FabianFriederichs/etching_bath_heater/README.md

# etching_bath_heater
An AVR 8-Bit µC based etching bath controller including PID controlled heater and agitation.
