FabianFriederichs/etching_bath_heater/case/STLs/MainbardAndMosfets.stl

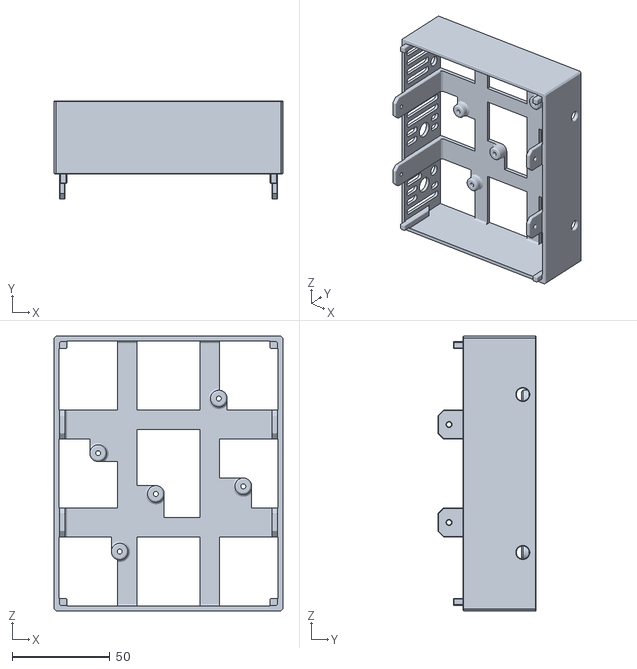
[picture p1: CAD file, 2020-09-18]
case/STLs/MainbardAndMosfets.stl
117.3 x 50.5 x 141.0
