FabianFriederichs/etching_bath_heater/case/MotorHolder.step

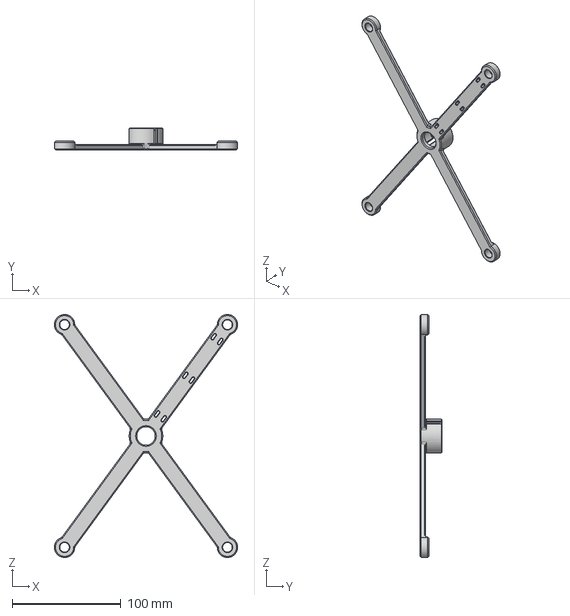
[picture p2: CAD file, 2020-10-12]
case/MotorHolder.step
168.8 x 20.0 x 223.8 mm
