FabianFriederichs/etching_bath_heater/case/STLs/Sensors_5VReg_Fan_Base.stl

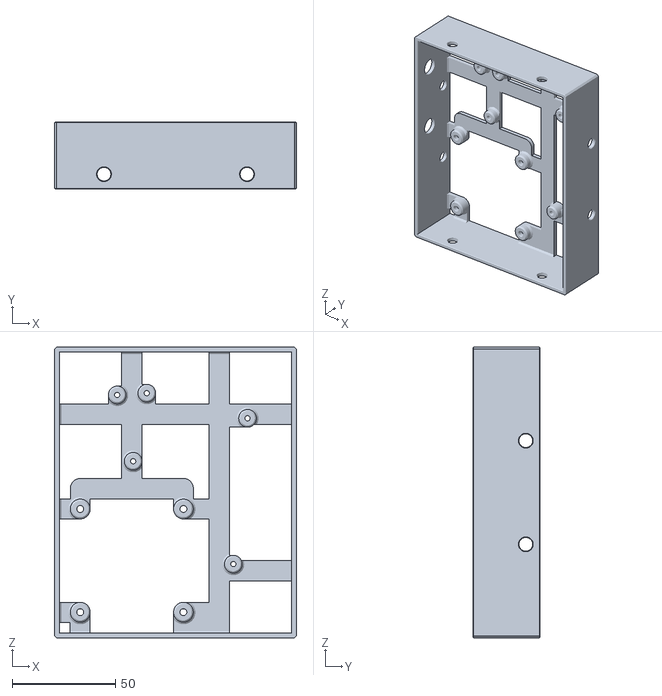
[picture p3: CAD file, 2020-09-18]
case/STLs/Sensors_5VReg_Fan_Base.stl
117.3 x 32.5 x 141.0
