FabianFriederichs/etching_bath_heater/case/MagnetHolder.step

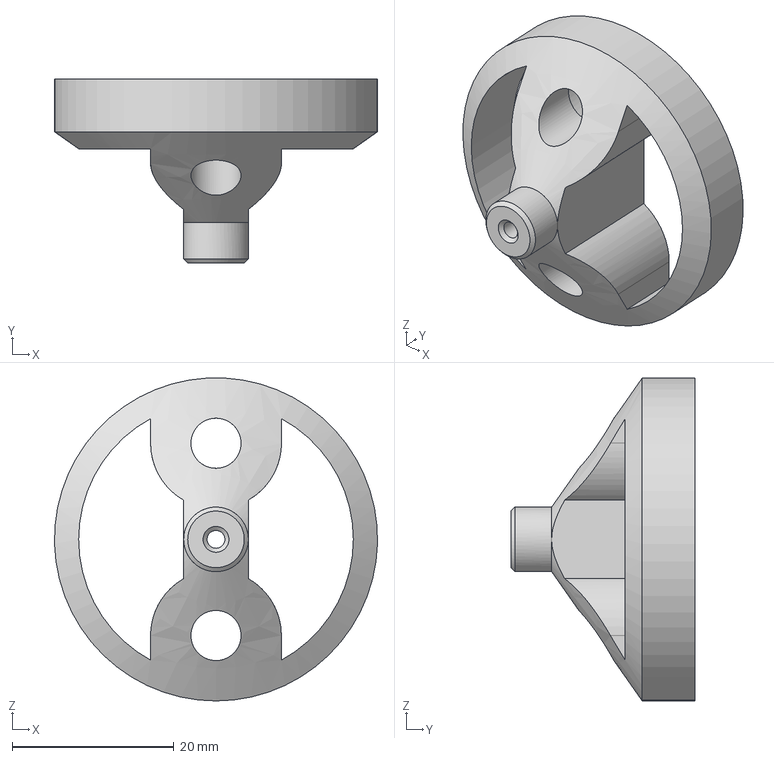
[picture p4: CAD file, 2020-10-12]
case/MagnetHolder.step
40.0 x 22.8 x 40.0 mm
