FabianFriederichs/etching_bath_heater/case/STLs/DisplayPart.stl

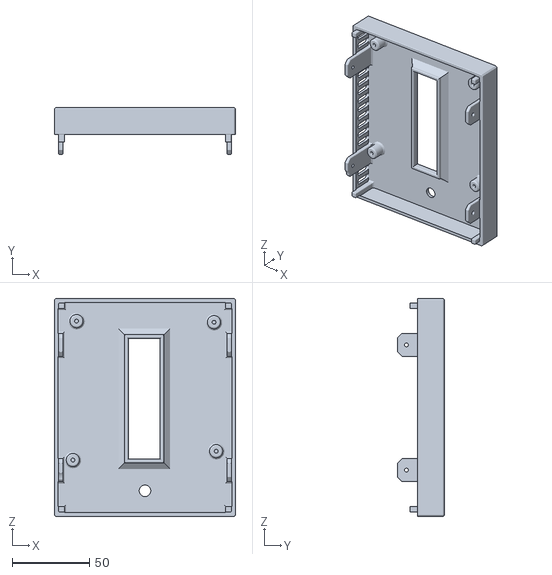
[picture p5: CAD file, 2020-09-18]
case/STLs/DisplayPart.stl
117.3 x 30.5 x 141.0
