FabianFriederichs/etching_bath_heater/case/PSUThing.step

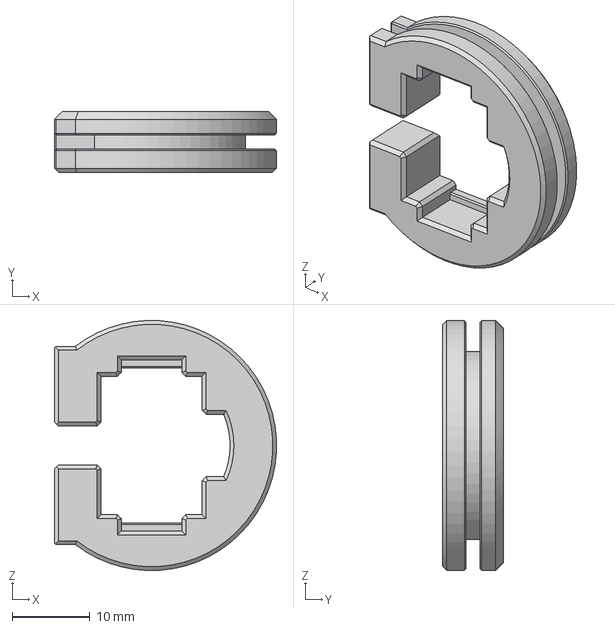
[picture p6: CAD file, 2020-09-29]
case/PSUThing.step
28.6 x 7.80 x 32.2 mm
