FabianFriederichs/etching_bath_heater/case/STLs/Base.stl

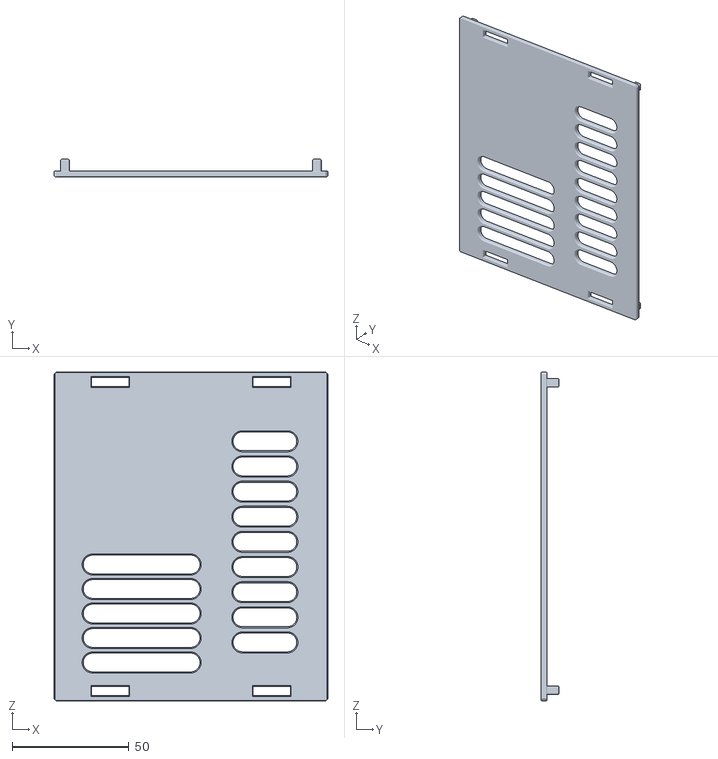
[picture p7: CAD file, 2020-09-18]
case/STLs/Base.stl
117.3 x 7.50 x 141.0
