FabianFriederichs/etching_bath_heater/case/RotEncKnob.step

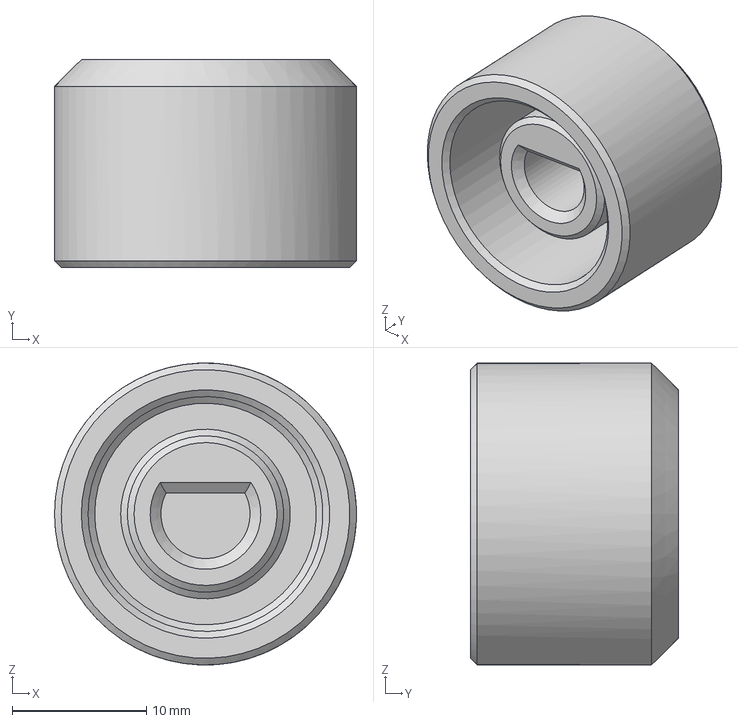
[picture p8: CAD file, 2020-09-28]
case/RotEncKnob.step
22.5 x 15.5 x 22.5 mm
