FabianFriederichs/etching_bath_heater/case/STLs/Stand.stl

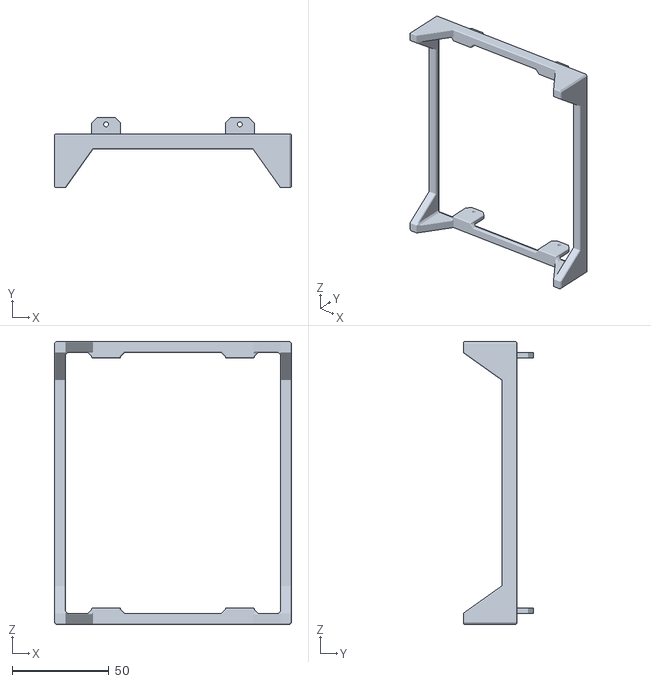
[picture p9: CAD file, 2020-09-18]
case/STLs/Stand.stl
122.9 x 36.5 x 146.6
