FabianFriederichs/etching_bath_heater/case/HeaterCase.step

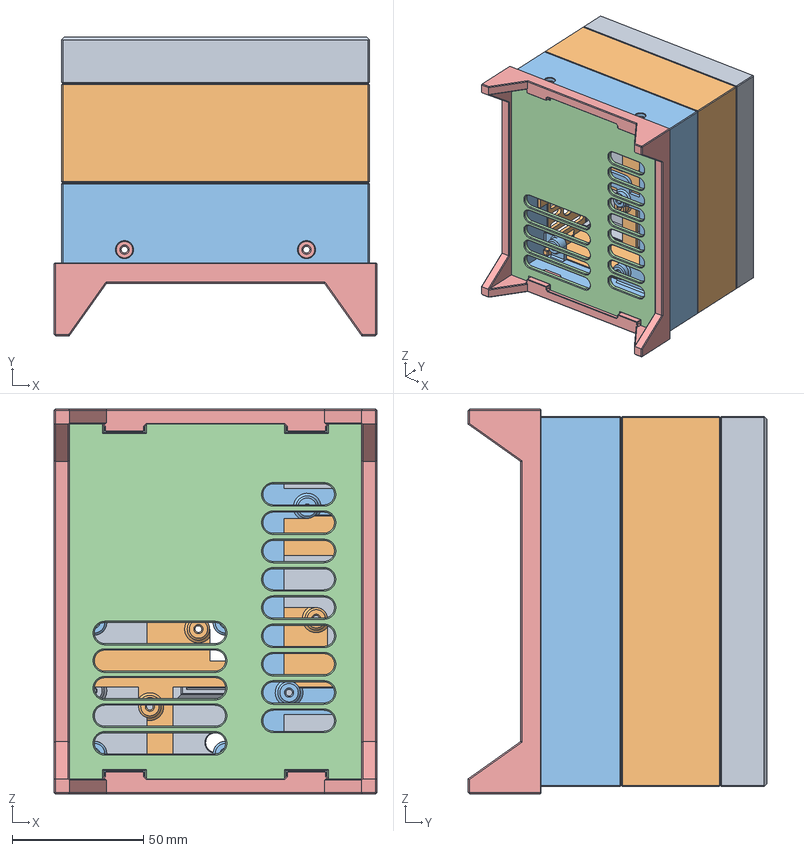
[picture p10: CAD file, 2020-09-15]
case/HeaterCase.step
122.9 x 113.7 x 146.6 mm
DisplayPart
MainbardAndMosfets
Sensors_5VReg_Fan_Base
Base
Stand
