FabianFriederichs/etching_bath_heater/case/STLs/StrainReliefPlugTighter.stl

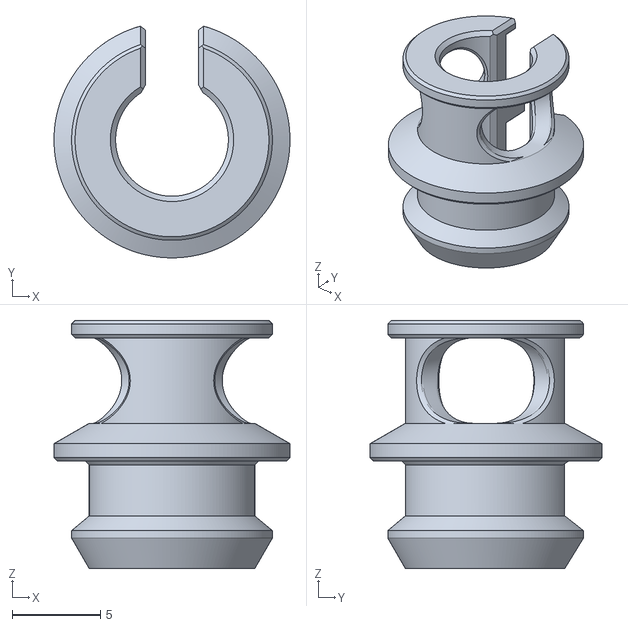
[picture p11: CAD file, 2020-09-18]
case/STLs/StrainReliefPlugTighter.stl
13.4 x 13.2 x 14.1
