FabianFriederichs/etching_bath_heater/(list of files, cad)

Other CAD files:
case/MagnetHolder.f3d
case/MotorHolder.f3d
case/PSUThing.f3d
case/RotEncKnob.f3d
case/STLs/MagnetHolder.stl
case/STLs/MotorHolder.stl
case/STLs/PSUThing.stl
case/STLs/RotEncKnob.stl
case/StrainReliefPlug.f3d
