FabianFriederichs/etching_bath_heater/pcbs_eagle/heater_motor.brd

## EAGLE design pcbs_eagle/heater_motor.brd (2020-02-20)

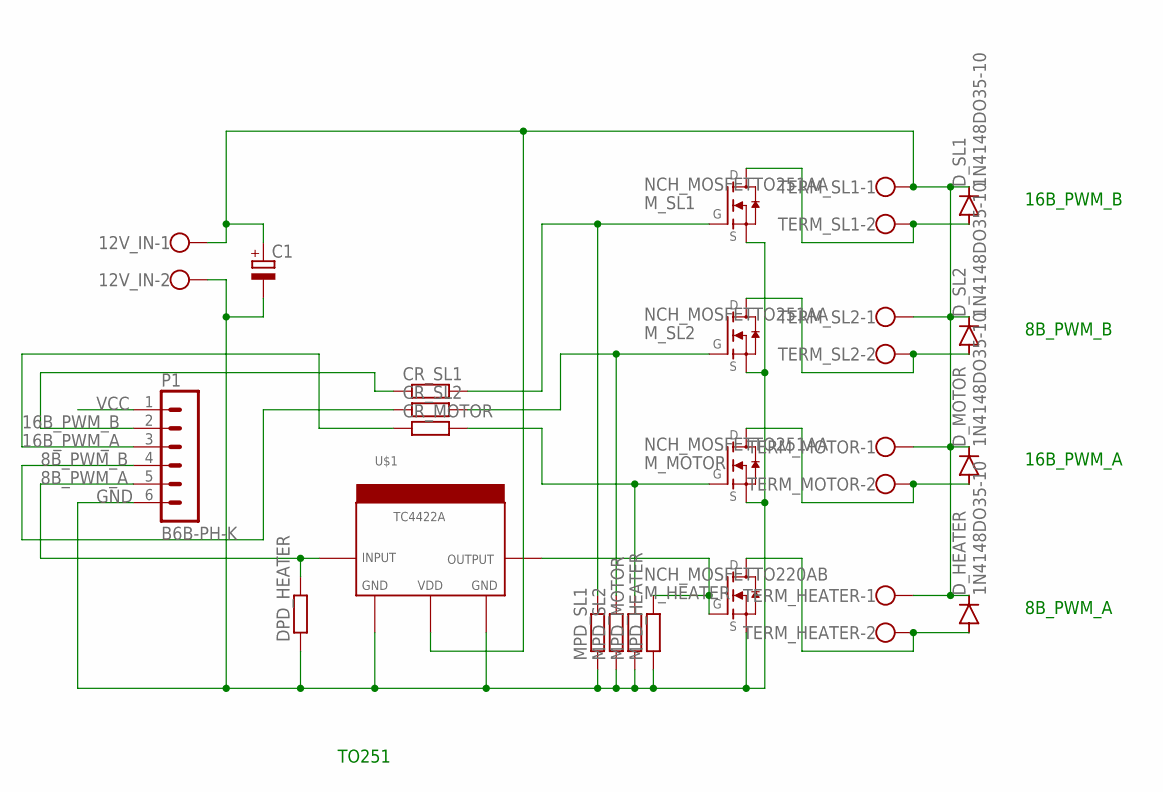
[picture p12: schematic heater_motor.sch]

Parts:
12V_IN: W237-102
C1: CPOL-EUE5-10.5; E5-10,5
CR_MOTOR: R-EU_0207/10; 0207/10
CR_SL1, CR_SL2: R-EU_0207/10; 0207/10
DPD_HEATER: R-EU_0207/10; 0207/10
D_HEATER: 1N4148DO35-10; DO35-10
D_MOTOR: 1N4148DO35-10; DO35-10
D_SL1, D_SL2: 1N4148DO35-10; DO35-10
MPD_HEATER: R-EU_0207/10; 0207/10
MPD_MOTOR: R-EU_0207/10; 0207/10
MPD_SL1, MPD_SL2: R-EU_0207/10; 0207/10
M_HEATER: NCH_MOSFETTO220AB; TO220AB
M_MOTOR: NCH_MOSFETTO251AA; TO251AA
M_SL1, M_SL2: NCH_MOSFETTO251AA; TO251AA
P1: B6B-PH-K
TERM_HEATER: W237-102
TERM_MOTOR: W237-102
TERM_SL1, TERM_SL2: W237-102
U$1: TC4422ASPACE_LEGS; TO220-52

Connections:
8B_PWM_A: DPD_HEATER.2, P1.5, U$1.1 (INPUT)
8B_PWM_B: CR_SL2.1, P1.4
16B_PWM_A: CR_MOTOR.1, P1.3
16B_PWM_B: CR_SL1.1, P1.2
GND: 12V_IN.2, C1.-, DPD_HEATER.1, MPD_HEATER.1, MPD_MOTOR.1, MPD_SL1.1, MPD_SL2.1, M_HEATER.3 (S), M_MOTOR.3 (S), M_SL1.3 (S), M_SL2.3 (S), P1.6, U$1.2 (GND1), U$1.4 (GND2)
unnamed: D_HEATER.A, M_HEATER.2 (D), TERM_HEATER.2
unnamed: MPD_HEATER.2, M_HEATER.1 (G), U$1.5 (OUTPUT)
unnamed: D_SL1.A, M_SL1.2 (D), TERM_SL1.2
unnamed: D_SL2.A, M_SL2.2 (D), TERM_SL2.2
unnamed: D_MOTOR.A, M_MOTOR.2 (D), TERM_MOTOR.2
unnamed: CR_MOTOR.2, MPD_MOTOR.2, M_MOTOR.1 (G)
unnamed: CR_SL2.2, MPD_SL2.2, M_SL2.1 (G)
unnamed: CR_SL1.2, MPD_SL1.2, M_SL1.1 (G)
unnamed: 12V_IN.1, C1.+, D_HEATER.C, D_MOTOR.C, D_SL1.C, D_SL2.C, TERM_HEATER.1, TERM_MOTOR.1, TERM_SL1.1, TERM_SL2.1, U$1.3 (VDD)
VCC: P1.1

Notes on the sheet:
TO251
8B_PWM_A
8B_PWM_B
16B_PWM_A
16B_PWM_B

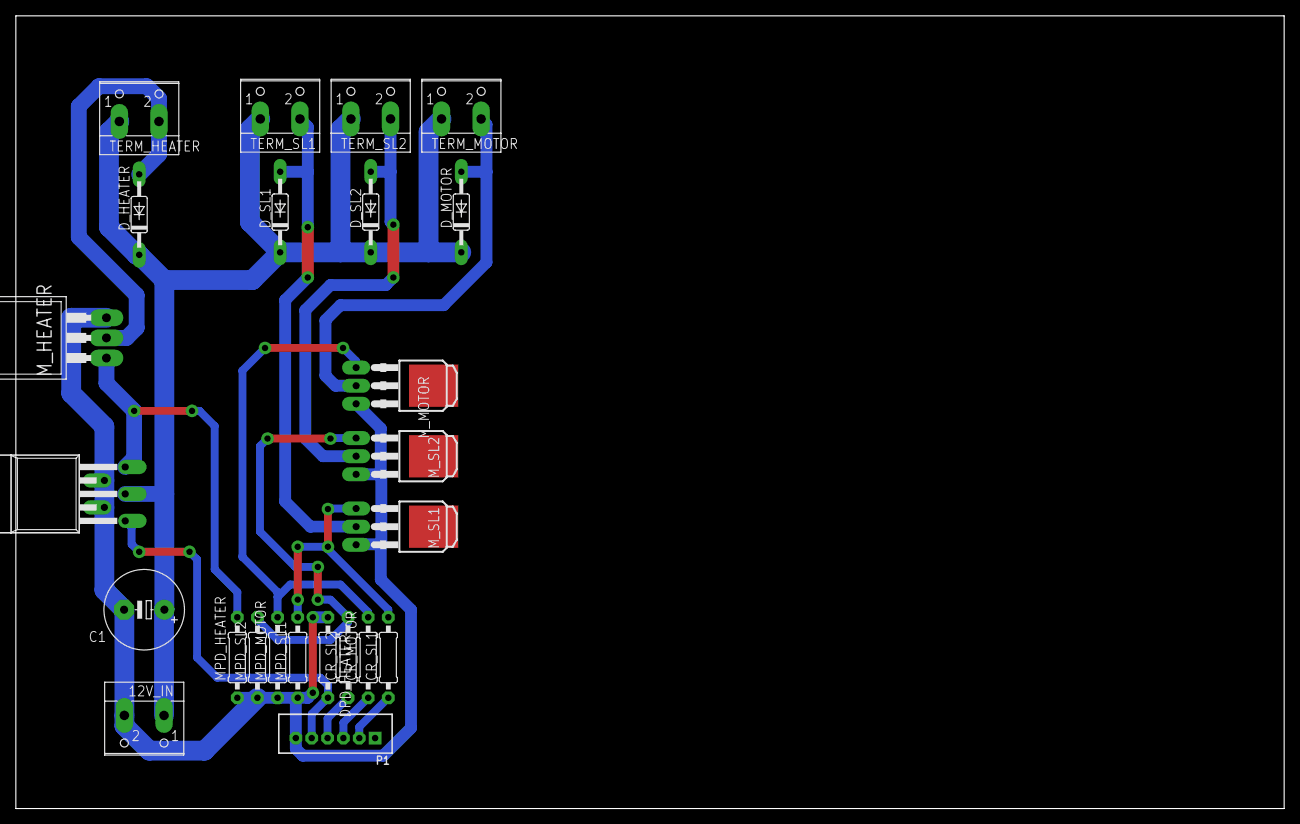
[picture p13: board heater_motor.brd from above]

Board: 2 copper layers, 160.0 x 100.0 mm, 24 parts (0 on the bottom side), 14 nets.
