FabianFriederichs/etching_bath_heater/pcbs_eagle/display.brd

## EAGLE design pcbs_eagle/display.brd (2020-02-20)

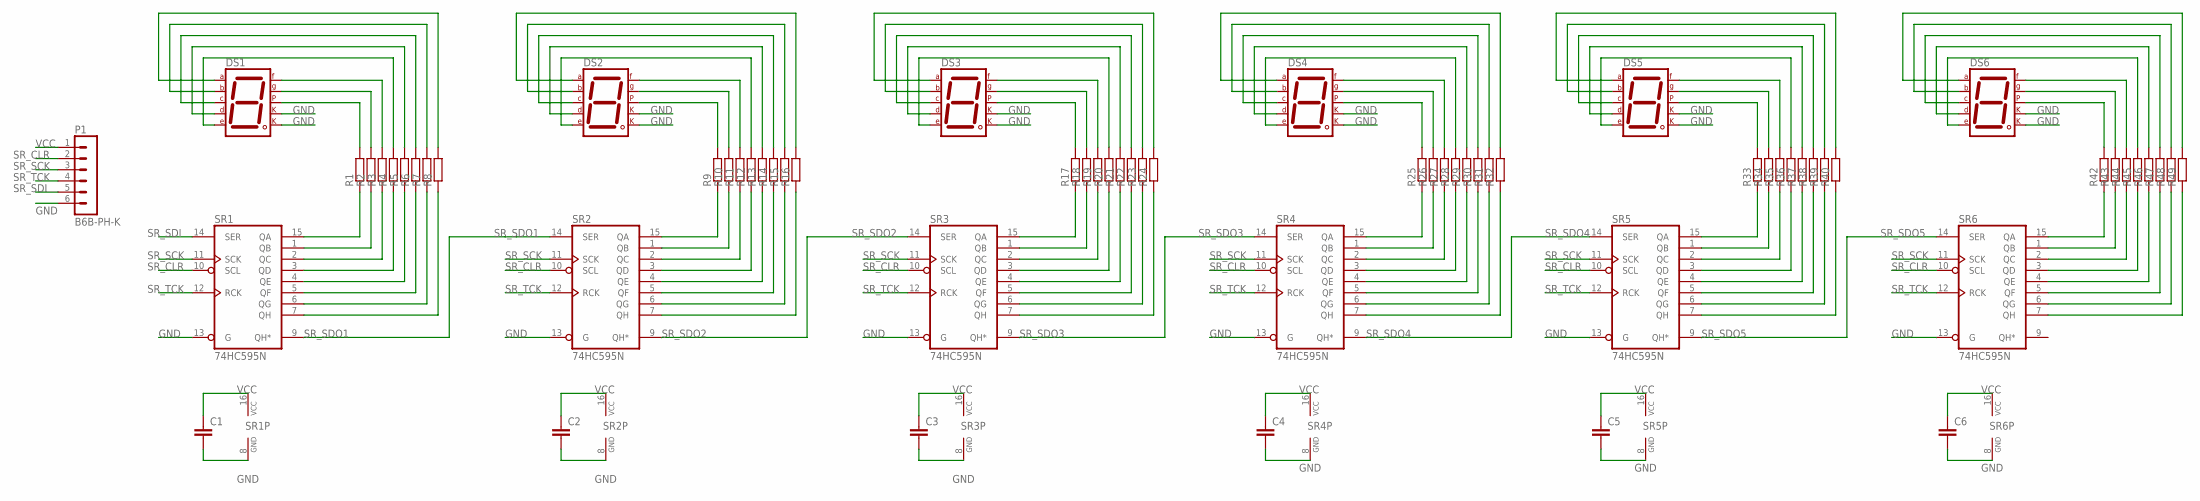
[picture p14: schematic display.sch]

Parts:
C1, C2, C3, C4, C5, C6: C-EU025-024X044; C025-024X044
DS1, DS2, DS3, DS4, DS5, DS6: 7SEG-CK; 7SEG-13
P1: B6B-PH-K
R1, R2, R3, R4, R5, R6, R7, R8, R9, R10, R11, R12, R13, R14, R15, R16, R17, R18, R19, R20, R21, R22, R23, R24, R25, R26, R27, R28, R29, R30, R31, R32, R33, R34, R35, R36, R37, R38, R39, R40, R42, R43, R44, R45, R46, R47, R48, R49: R-EU_0207/10; 0207/10
SR1, SR2, SR3, SR4, SR5, SR6: 74HC595N; DIL16

Connections:
GND: C1.2, C2.2, C3.2, C4.2, C5.2, C6.2, DS1.3 (CK1), DS1.8 (CK2), DS2.3 (CK1), DS2.8 (CK2), DS3.3 (CK1), DS3.8 (CK2), DS4.3 (CK1), DS4.8 (CK2), DS5.3 (CK1), DS5.8 (CK2), DS6.3 (CK1), DS6.8 (CK2), P1.6, SR1.8 (GND), SR1.13 (G), SR2.8 (GND), SR2.13 (G), SR3.8 (GND), SR3.13 (G), SR4.8 (GND), SR4.13 (G), SR5.8 (GND), SR5.13 (G), SR6.8 (GND), SR6.13 (G)
unnamed: R1.1, SR1.15 (QA)
unnamed: R2.1, SR1.1 (QB)
unnamed: R3.1, SR1.2 (QC)
unnamed: R4.1, SR1.3 (QD)
unnamed: R5.1, SR1.4 (QE)
unnamed: R6.1, SR1.5 (QF)
unnamed: R7.1, SR1.6 (QG)
unnamed: R8.1, SR1.7 (QH)
unnamed: R9.1, SR2.15 (QA)
unnamed: R10.1, SR2.1 (QB)
unnamed: R11.1, SR2.2 (QC)
unnamed: R12.1, SR2.3 (QD)
unnamed: R13.1, SR2.4 (QE)
unnamed: R14.1, SR2.5 (QF)
unnamed: R15.1, SR2.6 (QG)
unnamed: R16.1, SR2.7 (QH)
unnamed: R17.1, SR3.15 (QA)
unnamed: R18.1, SR3.1 (QB)
unnamed: R19.1, SR3.2 (QC)
unnamed: R20.1, SR3.3 (QD)
unnamed: R21.1, SR3.4 (QE)
unnamed: R22.1, SR3.5 (QF)
unnamed: R23.1, SR3.6 (QG)
unnamed: R24.1, SR3.7 (QH)
unnamed: R25.1, SR4.15 (QA)
unnamed: R26.1, SR4.1 (QB)
unnamed: R27.1, SR4.2 (QC)
unnamed: R28.1, SR4.3 (QD)
unnamed: R29.1, SR4.4 (QE)
unnamed: R30.1, SR4.5 (QF)
unnamed: R31.1, SR4.6 (QG)
unnamed: R32.1, SR4.7 (QH)
unnamed: R33.1, SR5.15 (QA)
unnamed: R34.1, SR5.1 (QB)
unnamed: R35.1, SR5.2 (QC)
unnamed: R36.1, SR5.3 (QD)
unnamed: R37.1, SR5.4 (QE)
unnamed: R38.1, SR5.5 (QF)
unnamed: R39.1, SR5.6 (QG)
unnamed: R40.1, SR5.7 (QH)
unnamed: R42.1, SR6.15 (QA)
unnamed: R43.1, SR6.1 (QB)
unnamed: R44.1, SR6.2 (QC)
unnamed: R45.1, SR6.3 (QD)
unnamed: R46.1, SR6.4 (QE)
unnamed: R47.1, SR6.5 (QF)
unnamed: R48.1, SR6.6 (QG)
unnamed: R49.1, SR6.7 (QH)
unnamed: DS1.5 (DP), R1.2
unnamed: DS1.10 (G), R2.2
unnamed: DS1.9 (F), R3.2
unnamed: DS1.1 (E), R4.2
unnamed: DS1.2 (D), R5.2
unnamed: DS1.4 (C), R6.2
unnamed: DS1.6 (B), R7.2
unnamed: DS1.7 (A), R8.2
unnamed: DS2.5 (DP), R9.2
unnamed: DS2.10 (G), R10.2
unnamed: DS2.9 (F), R11.2
unnamed: DS2.1 (E), R12.2
unnamed: DS2.2 (D), R13.2
unnamed: DS2.4 (C), R14.2
unnamed: DS2.6 (B), R15.2
unnamed: DS2.7 (A), R16.2
unnamed: DS3.5 (DP), R17.2
unnamed: DS3.10 (G), R18.2
unnamed: DS3.9 (F), R19.2
unnamed: DS3.1 (E), R20.2
unnamed: DS3.2 (D), R21.2
unnamed: DS3.4 (C), R22.2
unnamed: DS3.6 (B), R23.2
unnamed: DS3.7 (A), R24.2
unnamed: DS4.5 (DP), R25.2
unnamed: DS4.10 (G), R26.2
unnamed: DS4.9 (F), R27.2
unnamed: DS4.1 (E), R28.2
unnamed: DS4.2 (D), R29.2
unnamed: DS4.4 (C), R30.2
unnamed: DS4.6 (B), R31.2
unnamed: DS4.7 (A), R32.2
unnamed: DS5.5 (DP), R33.2
unnamed: DS5.10 (G), R34.2
unnamed: DS5.9 (F), R35.2
unnamed: DS5.1 (E), R36.2
unnamed: DS5.2 (D), R37.2
unnamed: DS5.4 (C), R38.2
unnamed: DS5.6 (B), R39.2
unnamed: DS5.7 (A), R40.2
unnamed: DS6.5 (DP), R42.2
unnamed: DS6.10 (G), R43.2
unnamed: DS6.9 (F), R44.2
unnamed: DS6.1 (E), R45.2
unnamed: DS6.2 (D), R46.2
unnamed: DS6.4 (C), R47.2
unnamed: DS6.6 (B), R48.2
unnamed: DS6.7 (A), R49.2
SR_CLR: P1.2, SR1.10 (SCL), SR2.10 (SCL), SR3.10 (SCL), SR4.10 (SCL), SR5.10 (SCL), SR6.10 (SCL)
SR_SCK: P1.3, SR1.11 (SCK), SR2.11 (SCK), SR3.11 (SCK), SR4.11 (SCK), SR5.11 (SCK), SR6.11 (SCK)
SR_SDI: P1.5, SR1.14 (SER)
SR_SDO1: SR1.9 (QH*), SR2.14 (SER)
SR_SDO2: SR2.9 (QH*), SR3.14 (SER)
SR_SDO3: SR3.9 (QH*), SR4.14 (SER)
SR_SDO4: SR4.9 (QH*), SR5.14 (SER)
SR_SDO5: SR5.9 (QH*), SR6.14 (SER)
SR_TCK: P1.4, SR1.12 (RCK), SR2.12 (RCK), SR3.12 (RCK), SR4.12 (RCK), SR5.12 (RCK), SR6.12 (RCK)
VCC: C1.1, C2.1, C3.1, C4.1, C5.1, C6.1, P1.1, SR1.16 (VCC), SR2.16 (VCC), SR3.16 (VCC), SR4.16 (VCC), SR5.16 (VCC), SR6.16 (VCC)

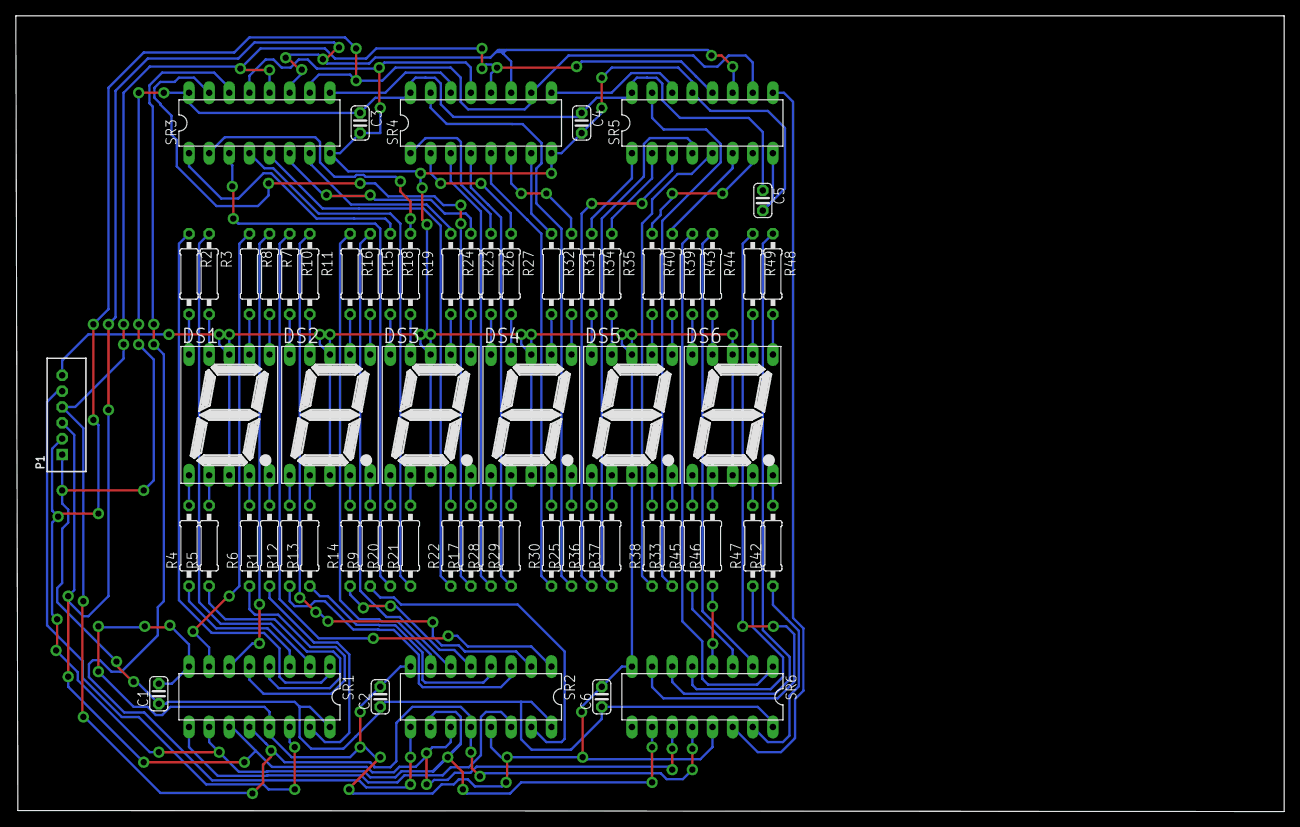
[picture p15: board display.brd from above]

Board: 2 copper layers, 160.0 x 100.4 mm, 67 parts (0 on the bottom side), 107 nets.
