FabianFriederichs/etching_bath_heater/pcbs_eagle/thermistor.brd

## EAGLE design pcbs_eagle/thermistor.brd (2020-02-20)

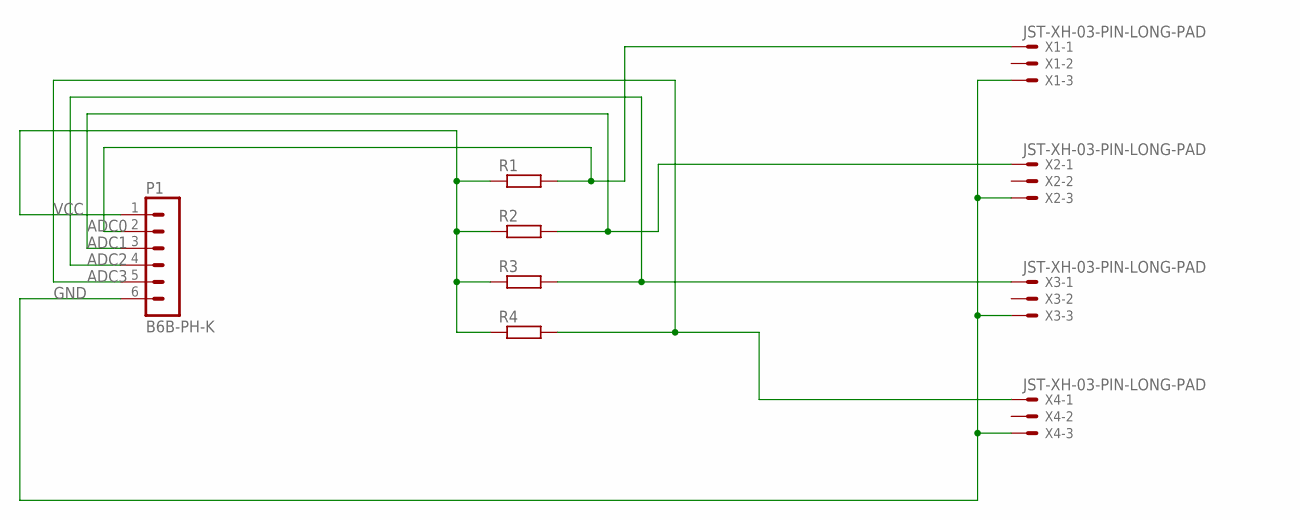
[picture p16: schematic thermistor.sch]

Parts:
P1: B6B-PH-K
R1, R2, R3, R4: R-EU_0207/10; 0207/10
X1, X2, X3, X4: JST-XH-03-PIN-LONG-PAD; JST-XH-03-PACKAGE-LONG-PAD

Connections:
ADC0: P1.2, R1.2, X1.1
ADC1: P1.3, R2.2, X2.1
ADC2: P1.4, R3.2, X3.1
ADC3: P1.5, R4.2, X4.1
GND: P1.6, X1.3, X2.3, X3.3, X4.3
VCC: P1.1, R1.1, R2.1, R3.1, R4.1

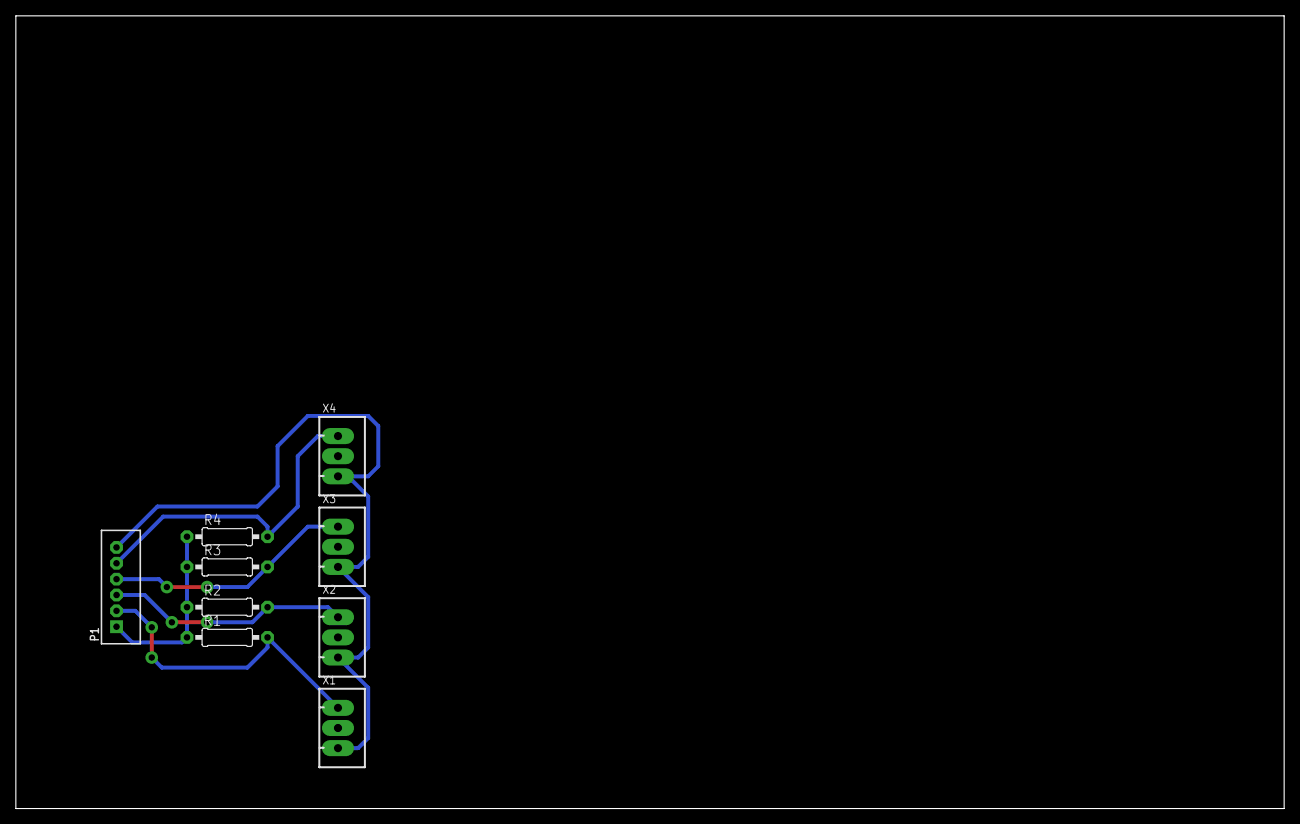
[picture p17: board thermistor.brd from above]

Board: 2 copper layers, 160.0 x 100.0 mm, 9 parts (0 on the bottom side), 6 nets.
