FabianFriederichs/etching_bath_heater/pcbs_eagle/mainboard.brd

## EAGLE design pcbs_eagle/mainboard.brd (2020-02-20)

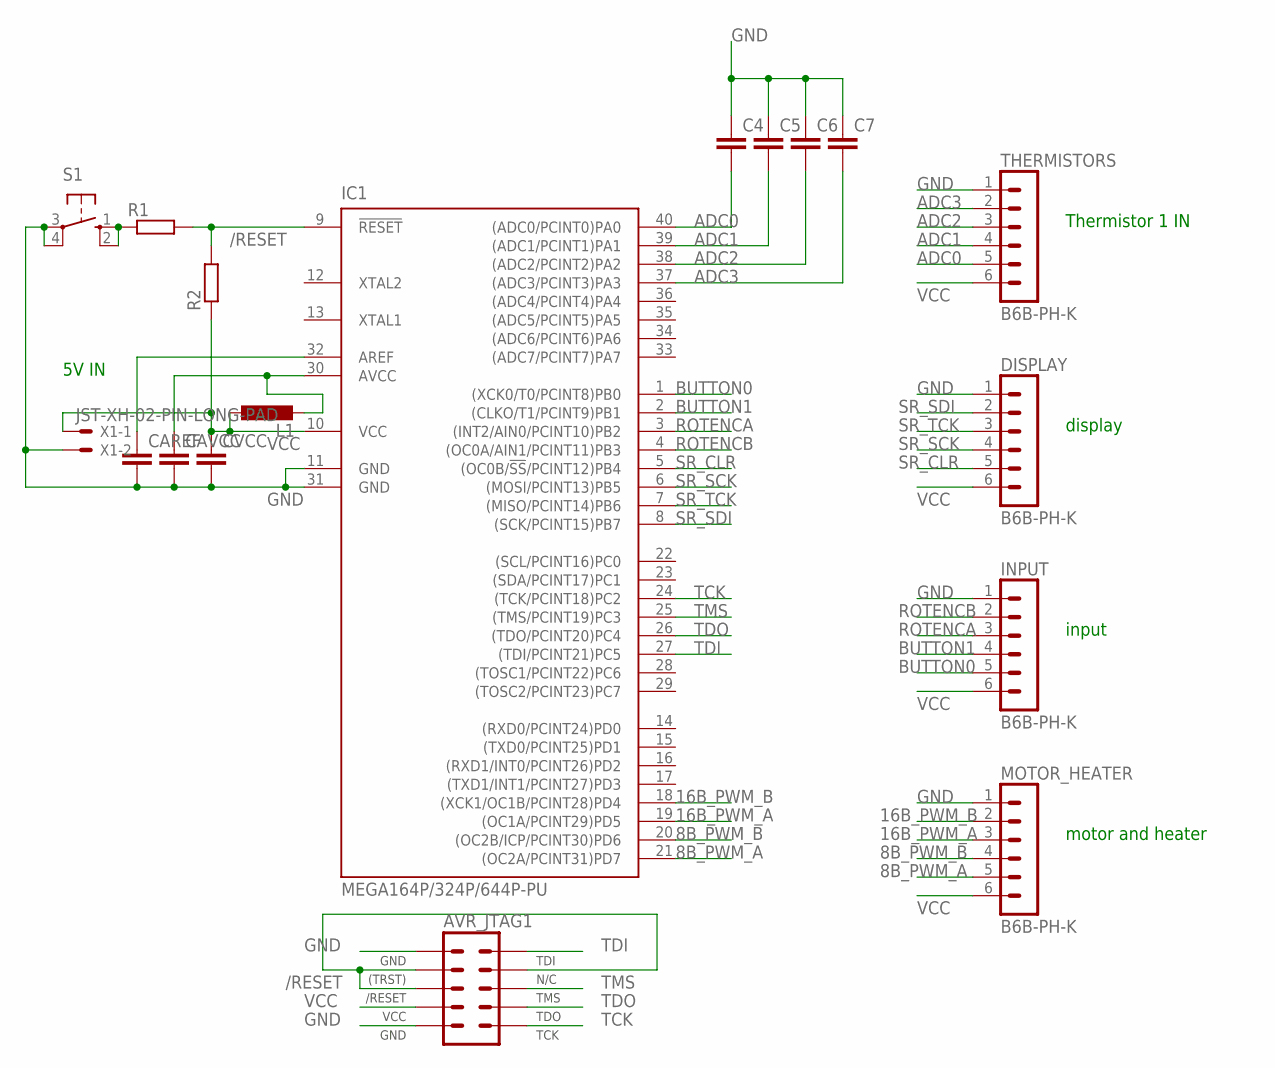
[picture p18: schematic mainboard.sch]

Parts:
AVR_JTAG1: AVR_JTAG_2X5/IN; AVR_JTAG_2X5
C4, C5, C6, C7: C-EU025-024X044; C025-024X044
CAREF: C-EU025-024X044; C025-024X044
CAVCC: C-EU025-024X044; C025-024X044
CVCC: C-EU025-024X044; C025-024X044
DISPLAY: B6B-PH-K
IC1: MEGA164P/324P/644P-PU; DIL40
INPUT: B6B-PH-K
L1: L-EU0207/10; 0207/10
MOTOR_HEATER: B6B-PH-K
R1, R2: R-EU_0207/10; 0207/10
S1: 10-XX; B3F-10XX
THERMISTORS: B6B-PH-K
X1: JST-XH-02-PIN-LONG-PAD; JST-XH-02-PACKAGE-LONG-PAD

Connections:
8B_PWM_A: IC1.21 ((OC2A/PCINT31)PD7), MOTOR_HEATER.5
8B_PWM_B: IC1.20 ((OC2B/ICP/PCINT30)PD6), MOTOR_HEATER.4
16B_PWM_A: IC1.19 ((OC1A/PCINT29)PD5), MOTOR_HEATER.3
16B_PWM_B: IC1.18 ((XCK1/OC1B/PCINT28)PD4), MOTOR_HEATER.2
/RESET: AVR_JTAG1.6 (/RESET), AVR_JTAG1.7 (N/C), AVR_JTAG1.8 ((TRST)), IC1.9 (!RESET), R1.2, R2.2
ADC0: C4.2, IC1.40 ((ADC0/PCINT0)PA0), THERMISTORS.5
ADC1: C5.2, IC1.39 ((ADC1/PCINT1)PA1), THERMISTORS.4
ADC2: C6.2, IC1.38 ((ADC2/PCINT2)PA2), THERMISTORS.3
ADC3: C7.2, IC1.37 ((ADC3/PCINT3)PA3), THERMISTORS.2
BUTTON0: IC1.1 ((XCK0/T0/PCINT8)PB0), INPUT.5
BUTTON1: IC1.2 ((CLKO/T1/PCINT9)PB1), INPUT.4
GND: AVR_JTAG1.2 (GND1), AVR_JTAG1.10 (GND2), C4.1, C5.1, C6.1, C7.1, CAREF.2, CAVCC.2, CVCC.2, DISPLAY.1, IC1.11 (GND), IC1.31 (GND), INPUT.1, MOTOR_HEATER.1, S1.3, S1.4 (P1), THERMISTORS.1, X1.2
unnamed: CAVCC.1, IC1.30 (AVCC), L1.2
unnamed: R1.1, S1.1 (S), S1.2 (S1)
unnamed: CAREF.1, IC1.32 (AREF)
ROTENCA: IC1.3 ((INT2/AIN0/PCINT10)PB2), INPUT.3
ROTENCB: IC1.4 ((OC0A/AIN1/PCINT11)PB3), INPUT.2
SR_CLR: DISPLAY.5, IC1.5 ((OC0B/!SS!/PCINT12)PB4)
SR_SCK: DISPLAY.4, IC1.6 ((MOSI/PCINT13)PB5)
SR_SDI: DISPLAY.2, IC1.8 ((SCK/PCINT15)PB7)
SR_TCK: DISPLAY.3, IC1.7 ((MISO/PCINT14)PB6)
TCK: AVR_JTAG1.1 (TCK), IC1.24 ((TCK/PCINT18)PC2)
TDI: AVR_JTAG1.9 (TDI), IC1.27 ((TDI/PCINT21)PC5)
TDO: AVR_JTAG1.3 (TDO), IC1.26 ((TDO/PCINT20)PC4)
TMS: AVR_JTAG1.5 (TMS), IC1.25 ((TMS/PCINT19)PC3)
VCC: AVR_JTAG1.4 (VCC), CVCC.1, DISPLAY.6, IC1.10 (VCC), INPUT.6, L1.1, MOTOR_HEATER.6, R2.1, THERMISTORS.6, X1.1

Notes on the sheet:
5V IN
Thermistor 1 IN
display
input
motor and heater

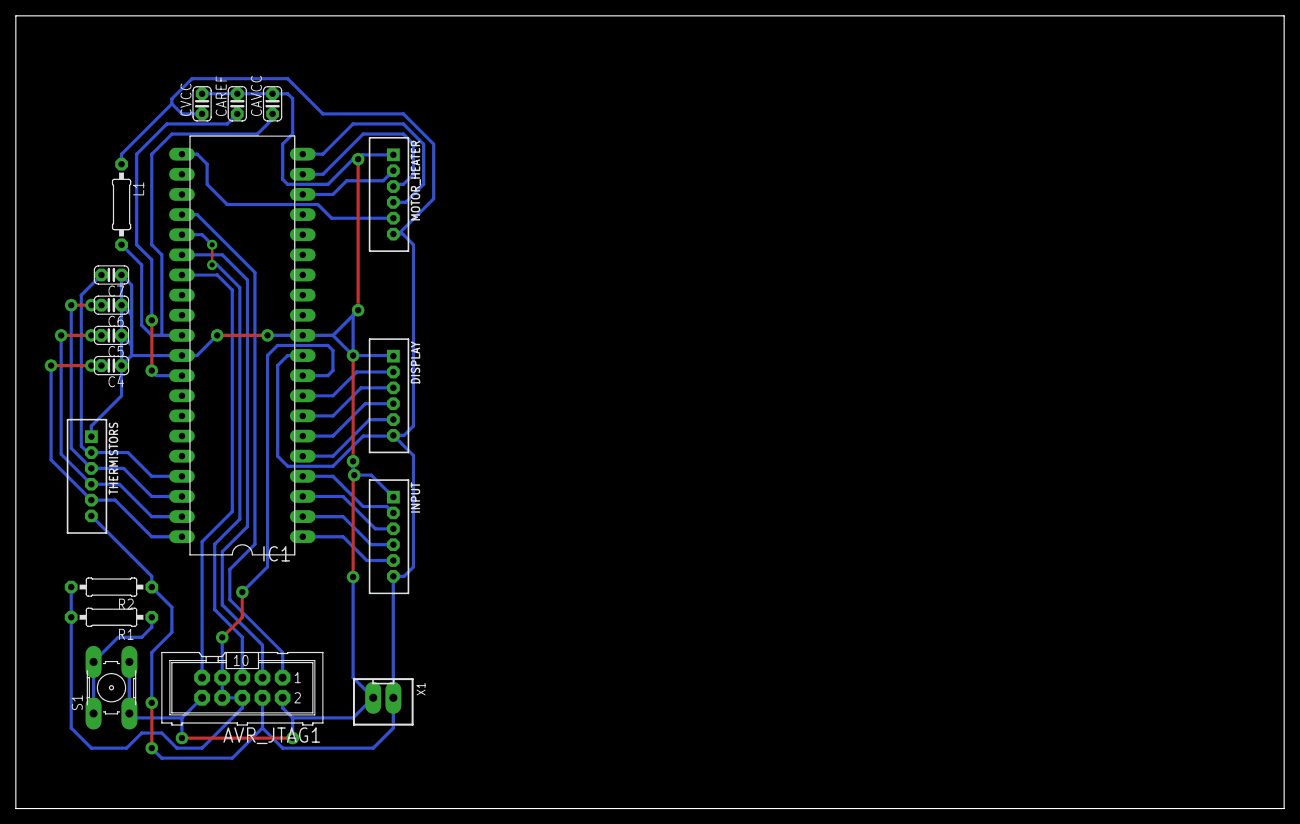
[picture p19: board mainboard.brd from above]

Board: 2 copper layers, 160.0 x 100.0 mm, 18 parts (0 on the bottom side), 26 nets.
