FabianFriederichs/etching_bath_heater/pcbs_eagle/powersupply.brd

## EAGLE design pcbs_eagle/powersupply.brd (2020-02-19)

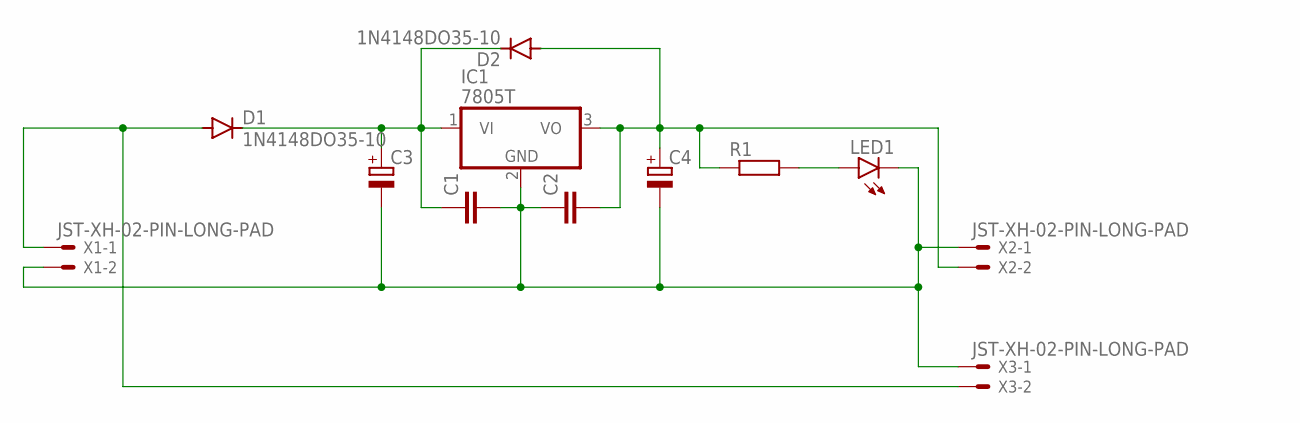
[picture p20: schematic powersupply.sch]

Parts:
C1, C2: C-EU025-024X044; C025-024X044
C3, C4: CPOL-EUE2,5-6E; E2,5-6E
D1, D2: 1N4148DO35-10; DO35-10
IC1: 7805T; TO220H
LED1: LED5MM
R1: R-EU_0207/10; 0207/10
X1, X2, X3: JST-XH-02-PIN-LONG-PAD; JST-XH-02-PACKAGE-LONG-PAD

Connections:
GND: C1.2, C2.1, C3.-, C4.-, IC1.2 (GND), LED1.K (C), X1.2, X2.1, X3.1
unnamed: D1.A, X1.1, X3.2
unnamed: C1.1, C3.+, D1.C, D2.C, IC1.1 (VI)
unnamed: C2.2, C4.+, D2.A, IC1.3 (VO), R1.1, X2.2
unnamed: LED1.A, R1.2

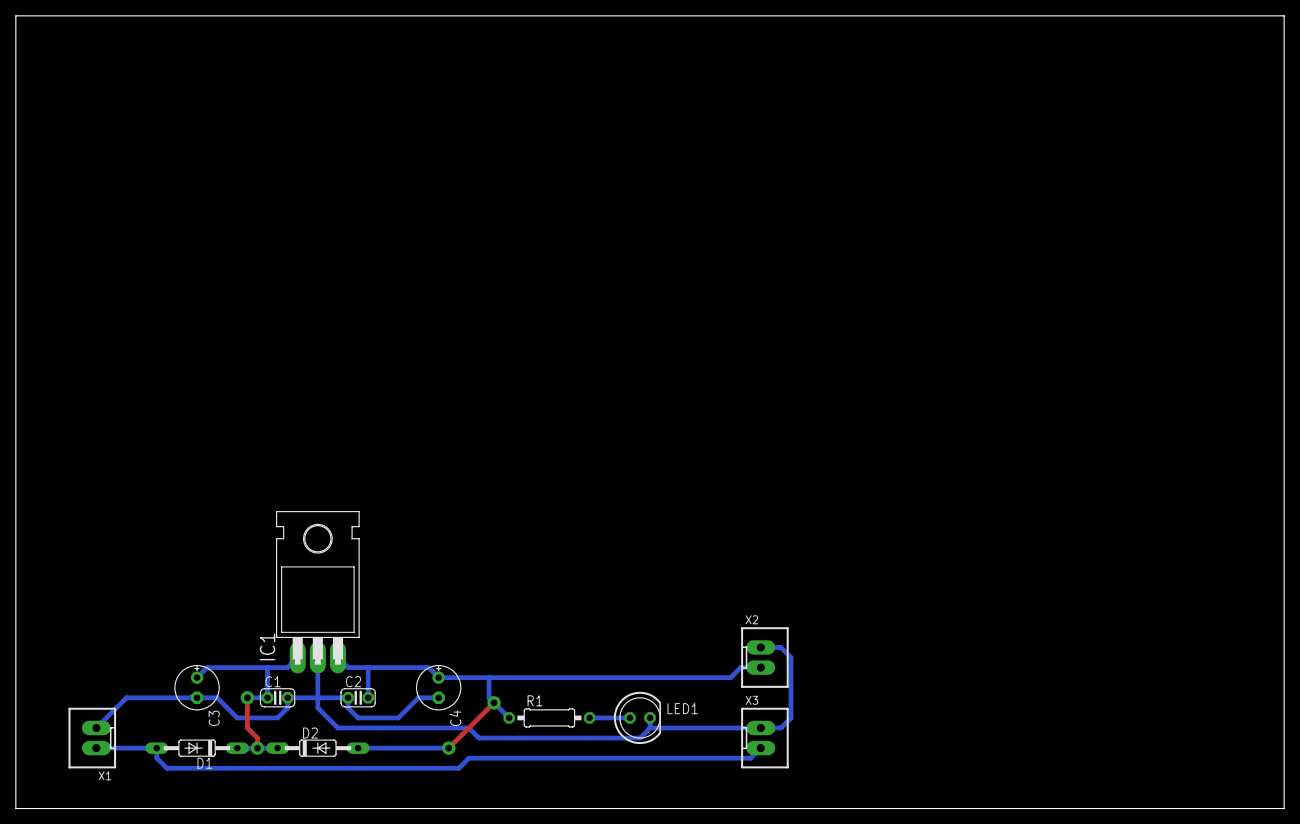
[picture p21: board powersupply.brd from above]

Board: 2 copper layers, 160.0 x 100.0 mm, 12 parts (0 on the bottom side), 5 nets.
