FabianFriederichs/etching_bath_heater/pcbs_eagle/input.brd

## EAGLE design pcbs_eagle/input.brd (2020-02-17)

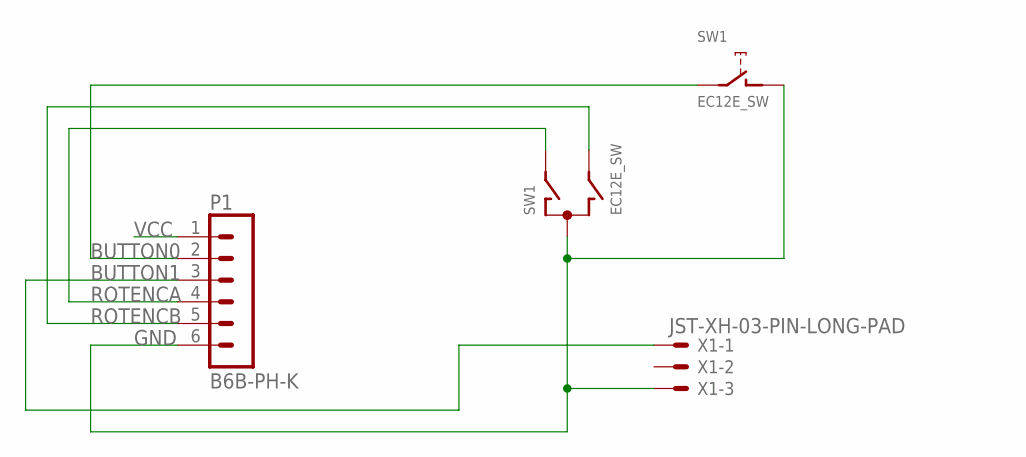
[picture p22: schematic input.sch]

Parts:
P1: B6B-PH-K
SW1: EC12E_SW; ALPS_EC12E_SW
X1: JST-XH-03-PIN-LONG-PAD; JST-XH-03-PACKAGE-LONG-PAD

Connections:
BUTTON0: P1.2, SW1.E (2)
BUTTON1: P1.3, X1.1
GND: P1.6, SW1.C, SW1.D (1), X1.3
ROTENCA: P1.4, SW1.A
ROTENCB: P1.5, SW1.B
VCC: P1.1

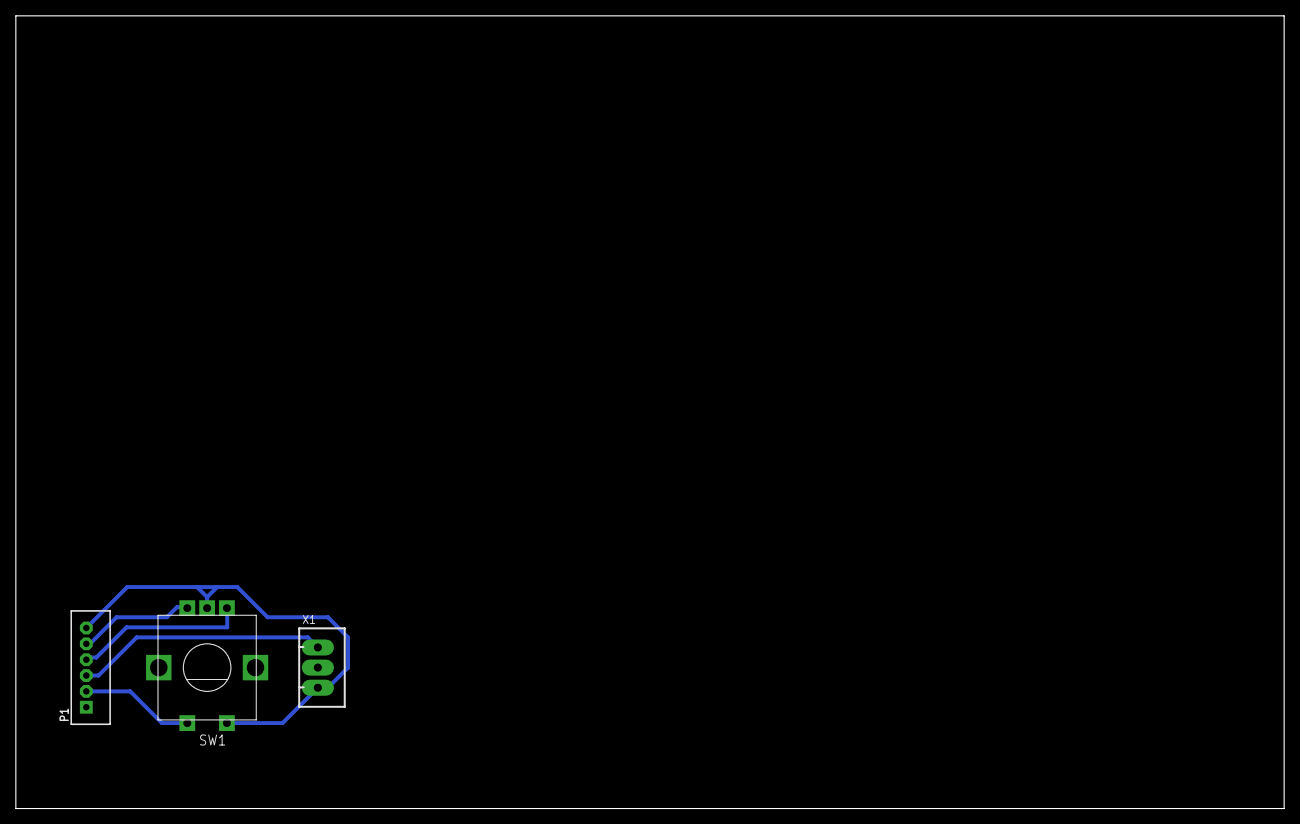
[picture p23: board input.brd from above]

Board: 2 copper layers, 160.0 x 100.0 mm, 3 parts (0 on the bottom side), 5 nets.
