FabianFriederichs/etching_bath_heater/atmel_studio_project/pidetchingbath/pidetchingbath/main.c

/*
MIT License

Copyright (c) 2020 Fabian Friederichs

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
THE SOFTWARE IS PROVIDED "AS IS", WITHOUT WARRANTY OF ANY KIND, EXPRESS OR
IMPLIED, INCLUDING BUT NOT LIMITED TO THE WARRANTIES OF MERCHANTABILITY,
FITNESS FOR A PARTICULAR PURPOSE AND NONINFRINGEMENT. IN NO EVENT SHALL THE
AUTHORS OR COPYRIGHT HOLDERS BE LIABLE FOR ANY CLAIM, DAMAGES OR OTHER
LIABILITY, WHETHER IN AN ACTION OF CONTRACT, TORT OR OTHERWISE, ARISING FROM,
OUT OF OR IN CONNECTION WITH THE SOFTWARE OR THE USE OR OTHER DEALINGS IN THE
SOFTWARE.
 */ 

#include "application.h"

int main(void)
{
	ErrorCode res = app_run();
	if(res) // if error occured, block forever, keeping the error message on the display
	{
		while(TRUE) {};
	}
}
