FabianFriederichs/etching_bath_heater/(commit log)

2020-02-18 fixed eeprom menu strings
    [menu_rendering.c]
2020-02-18 fixed pid d bug
    [PID.c, PID.h]
2020-02-18 added adjustable i-clamping
2020-02-20 ground planes
    [display.brd, heater_motor.brd, mainboard.brd, thermistor.brd]
2020-02-25 changed pid derivative to PV-based derivative
2020-02-26 changed pid parameterization
2020-02-26 finished pid stuff. needs to be tested.
2020-02-28 Fixed floating point display.
    [application.h, config.h, my_util.c, my_util.h, srdisplay.c]
2020-05-24 increased heater max temp
2020-09-13 Heater case in progress...
    [HeaterCase v8.f3d, HeaterCase.step, display_plate_draft.stl]
2020-09-15 Case V1 finished
    [HeaterCase.step]
2020-09-16 Modified strain relief plug for printing with PP
    [Base.stl, DisplayPart.stl, MainbardAndMosfets.stl, Sensors_5VReg_Fan_Base.stl, Stand.stl, StrainReliefPlug.f3d, StrainReliefPlug.stl, StrainReliefPlugTighter.stl]
2020-09-18 Case stuff
    [Base.stl, DisplayPart.stl, MainbardAndMosfets.stl, Sensors_5VReg_Fan_Base.stl, Stand.stl, StrainReliefPlug.f3d, StrainReliefPlug.stl, StrainReliefPlugTighter.stl]
2020-09-23 fan control
2020-09-23 fan control works
2020-09-29 more stuff
    [PSUThing.f3d, PSUThing.step, PSUThing.stl]
2020-10-03 created remaining case parts
    [MagnetHolder.f3d, MagnetHolder.step, MagnetHolder.stl, MotorHolder.f3d, MotorHolder.step, MotorHolder.stl]
2020-10-12 reduced heater pwm frequency and adjusted thermal runaway protection params
