FabianFriederichs/etching_bath_heater/(notices)

Notices in the files:
parts and their libraries:
con-jst-ph: Copyright (C) 2016, Bob Starr
